efeemir103/DigitalDesignProject/README.md

# DigitalDesignProject
A simple design containing 16-bit custom CPU design, VGA Controller and IR Controller designs

Made by:

Efe Emir Pekmez

Alperen Yurdakul

Bahtiyar Annagurbanov
