efeemir103/DigitalDesignProject/Related/ALU.png

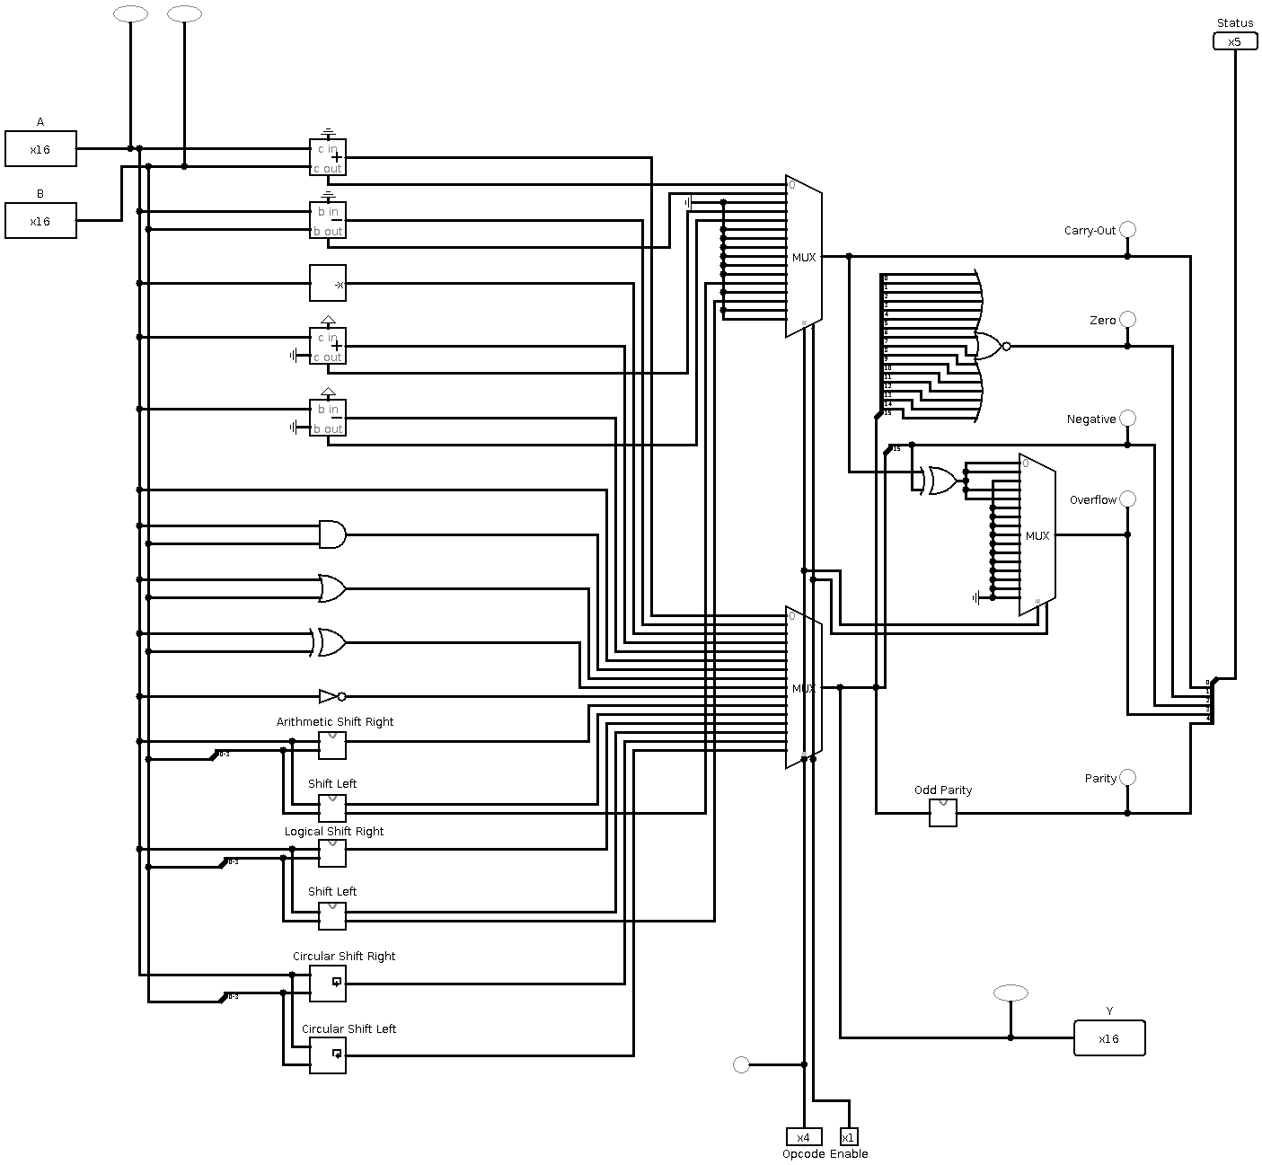
Related/ALU.png
