efeemir103/DigitalDesignProject/Related/Comparator2Bit.png

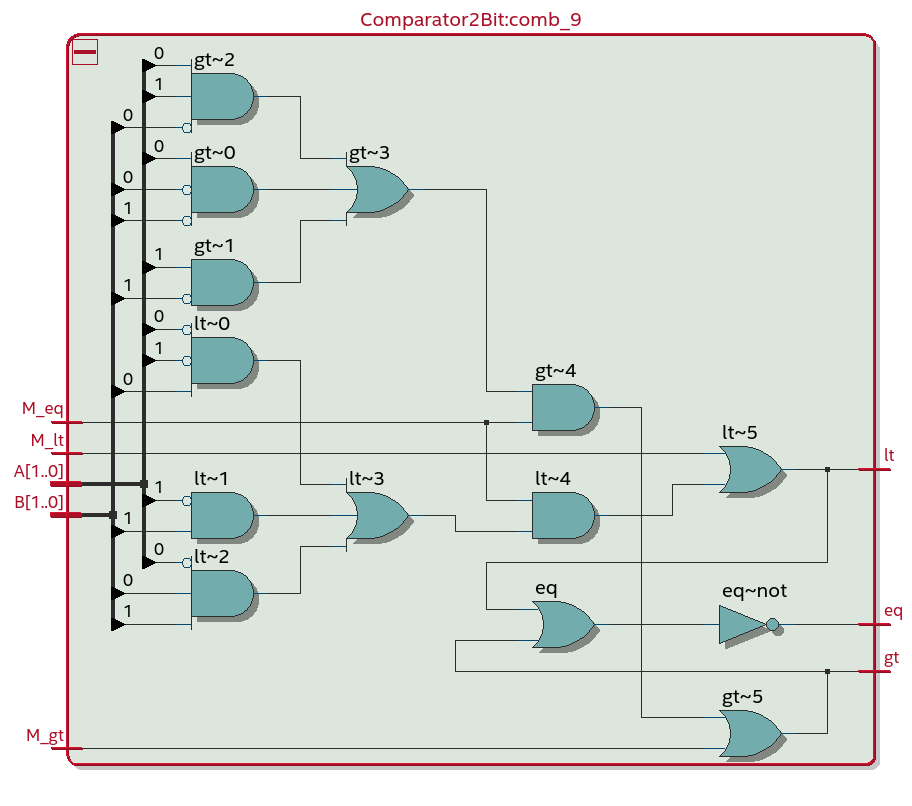
Related/Comparator2Bit.png
