efeemir103/DigitalDesignProject/Related/Comparator16Bit.png

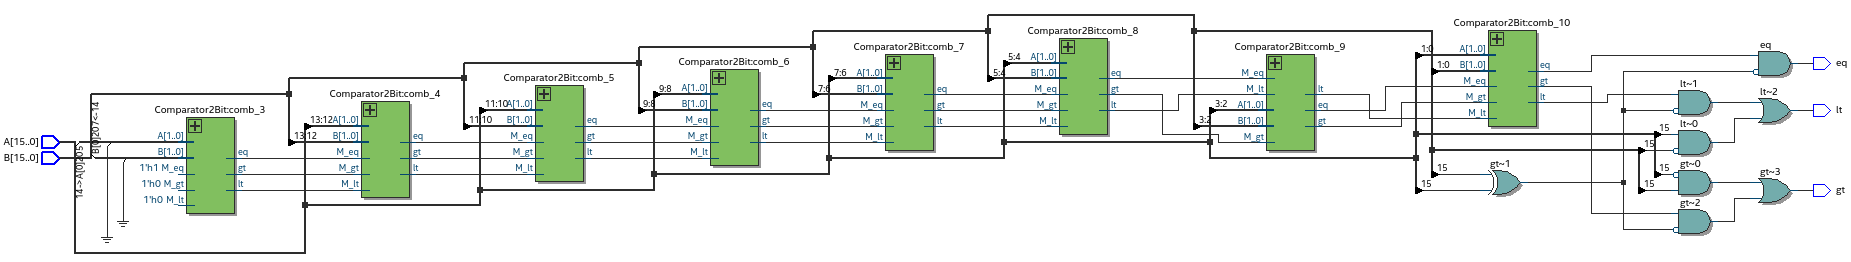
Related/Comparator16Bit.png
