efeemir103/DigitalDesignProject/Related/main.png

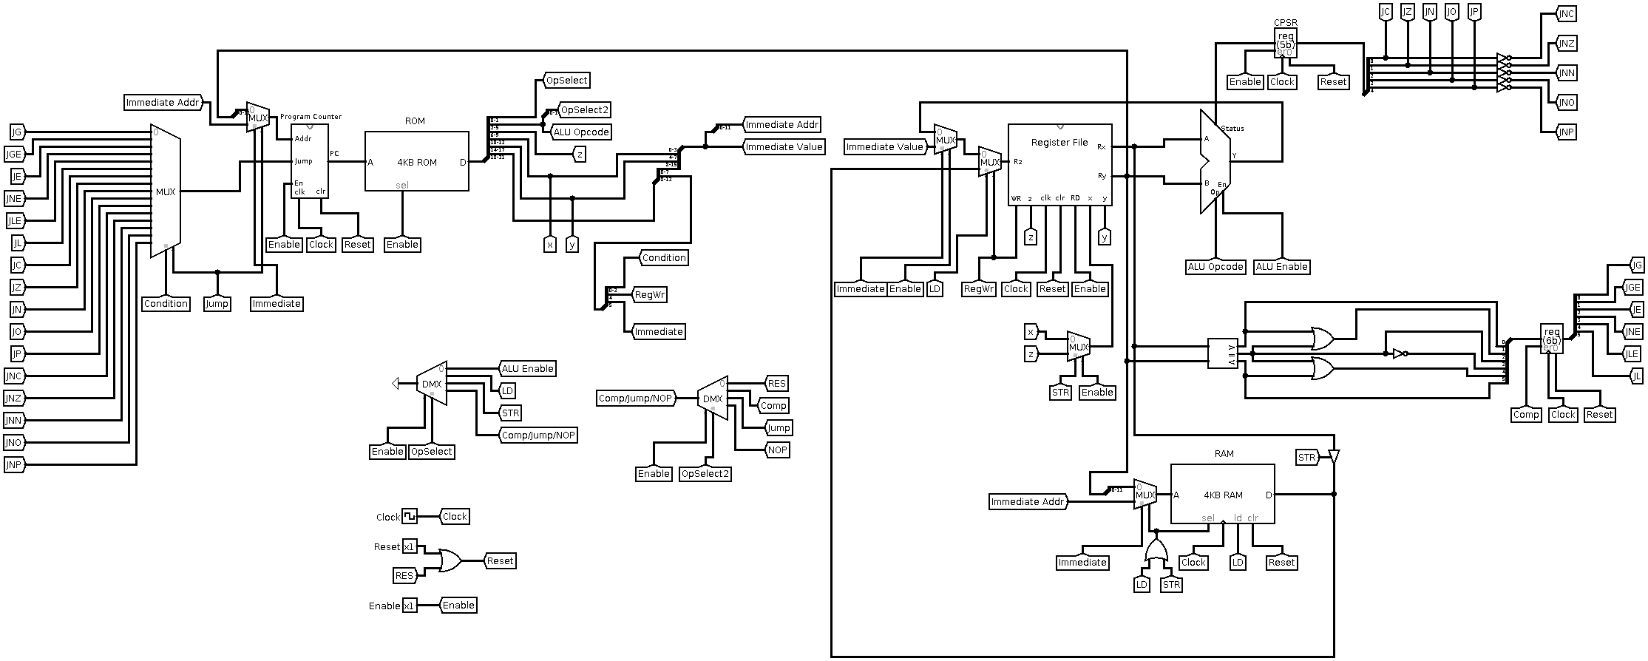
Related/main.png
