efeemir103/DigitalDesignProject/Related/Odd Parity.png

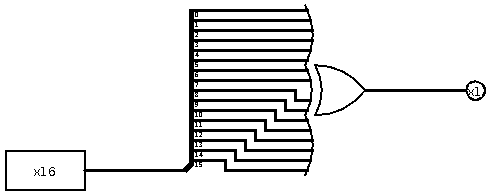
Related/Odd Parity.png
