efeemir103/DigitalDesignProject/Related/Program Counter.png

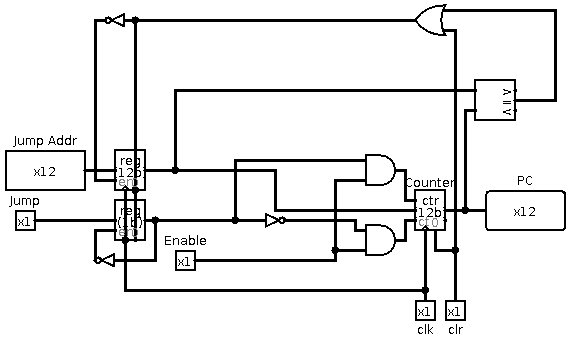
Related/Program Counter.png
