efeemir103/DigitalDesignProject/Related/Register File.png

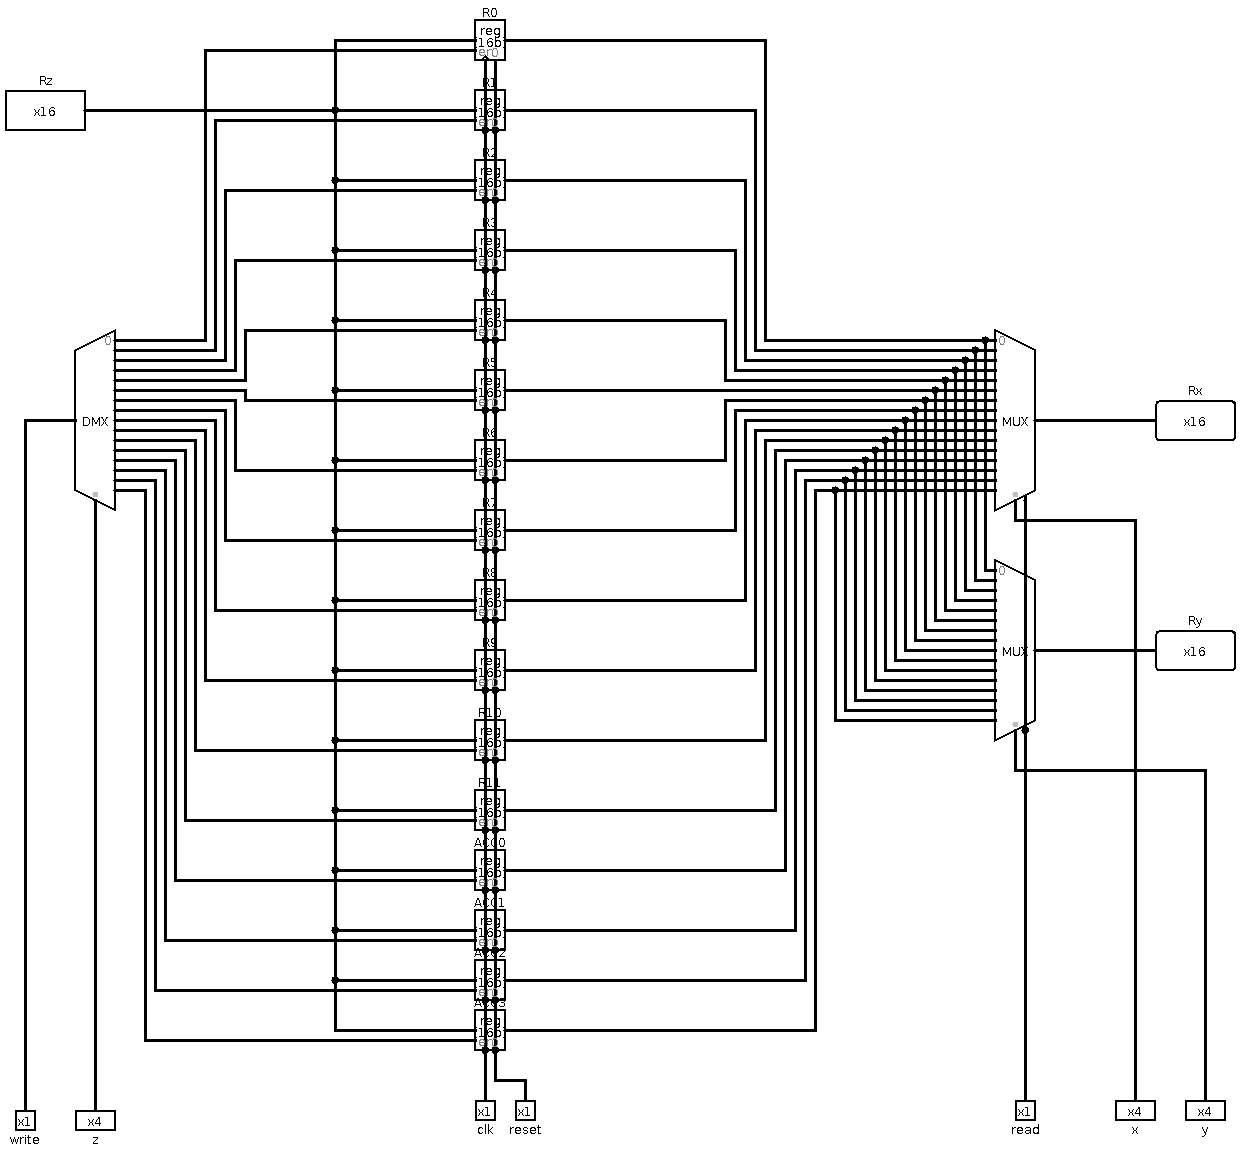
Related/Register File.png
