efeemir103/DigitalDesignProject/Related/Report/CPU/Adder16Bit.png

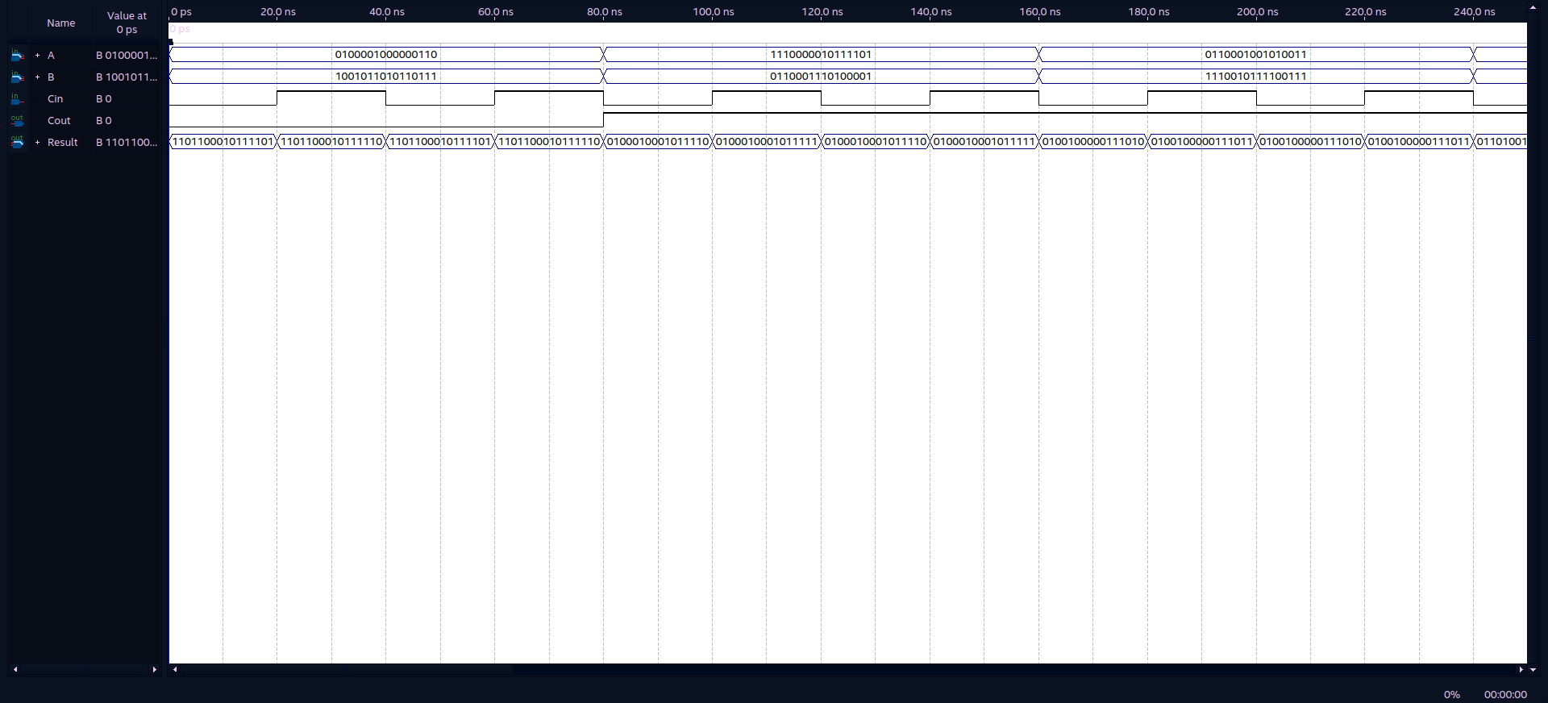
Related/Report/CPU/Adder16Bit.png
