efeemir103/DigitalDesignProject/Related/Report/CPU/ALU16Bit.png

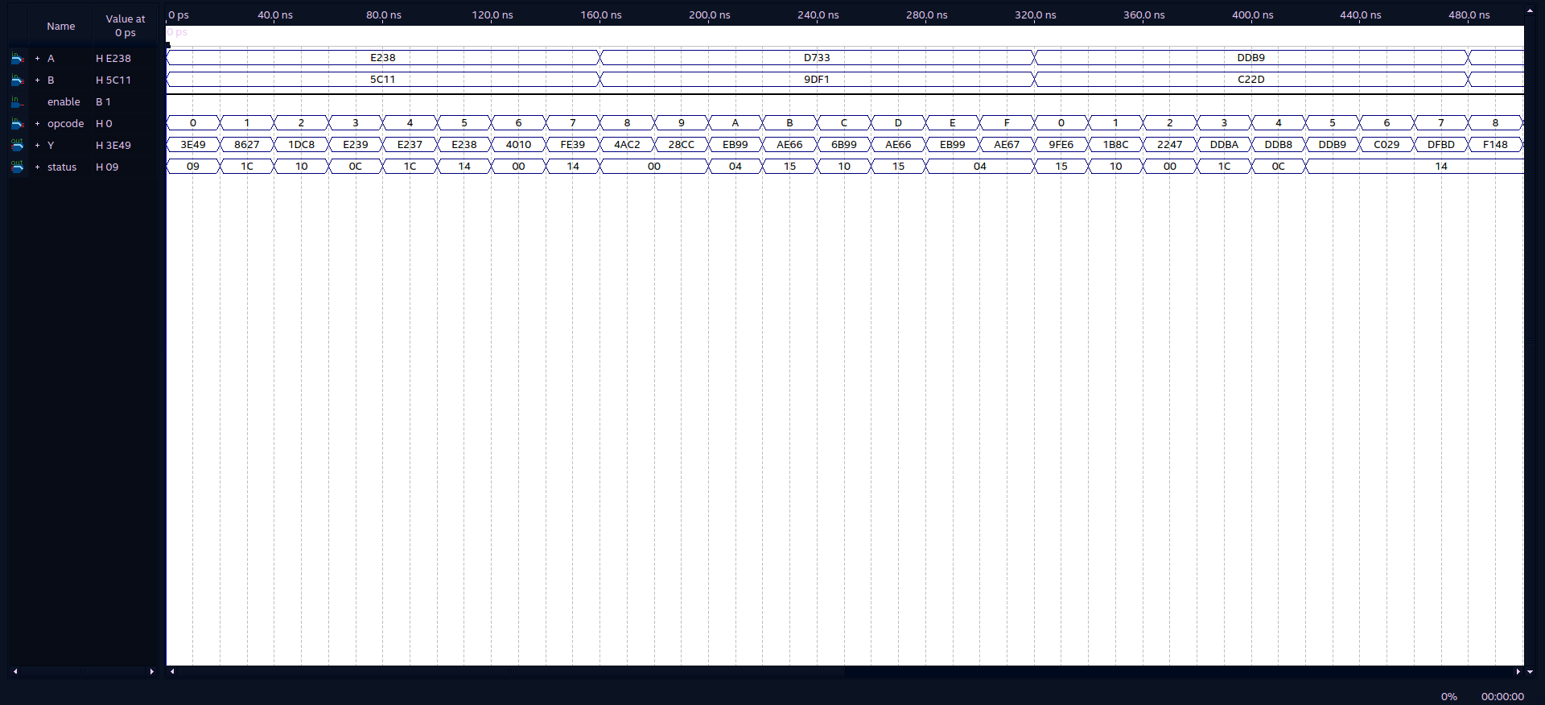
Related/Report/CPU/ALU16Bit.png
