efeemir103/DigitalDesignProject/Related/Report/CPU/ArithmeticShiftRight16Bit.png

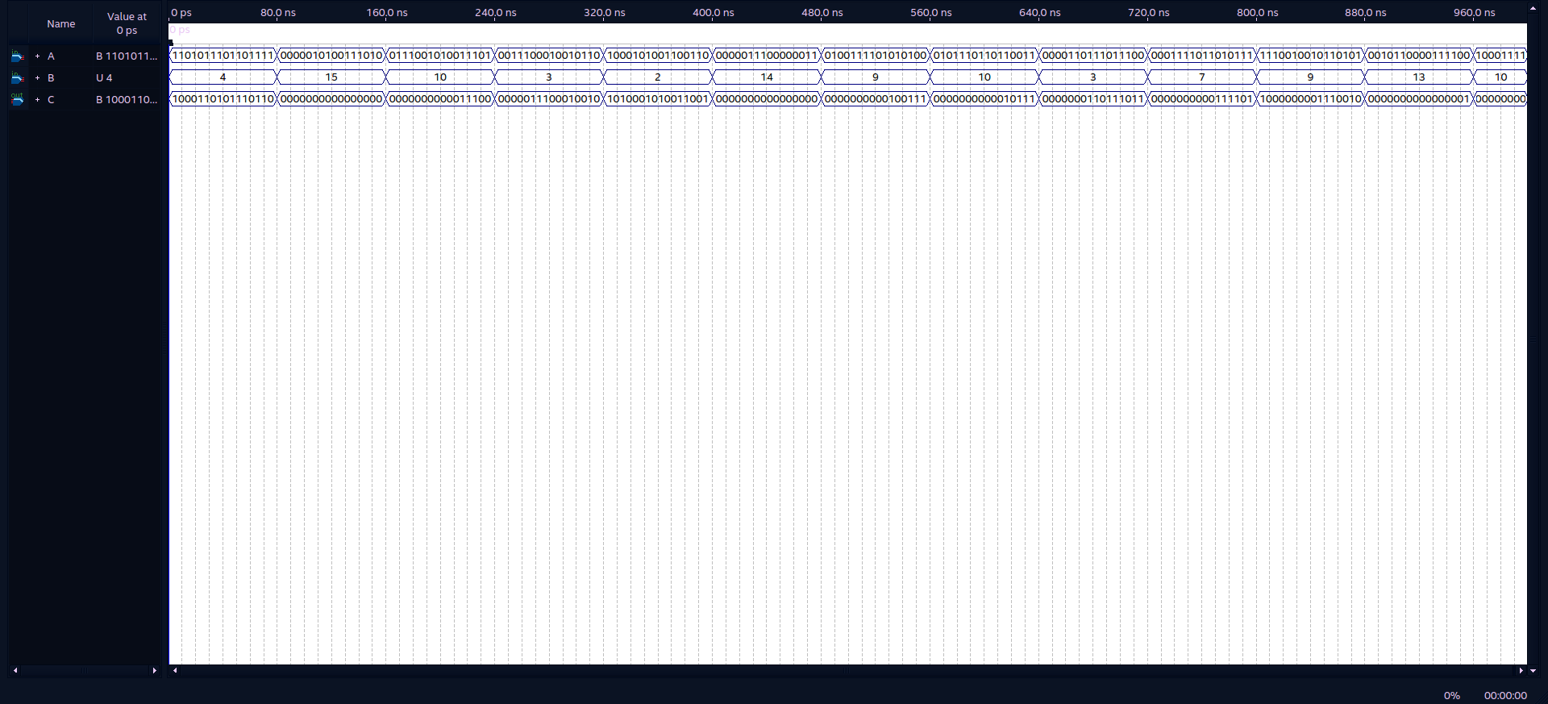
Related/Report/CPU/ArithmeticShiftRight16Bit.png
