efeemir103/DigitalDesignProject/Related/Report/CPU/CircularShiftRight16Bit.png

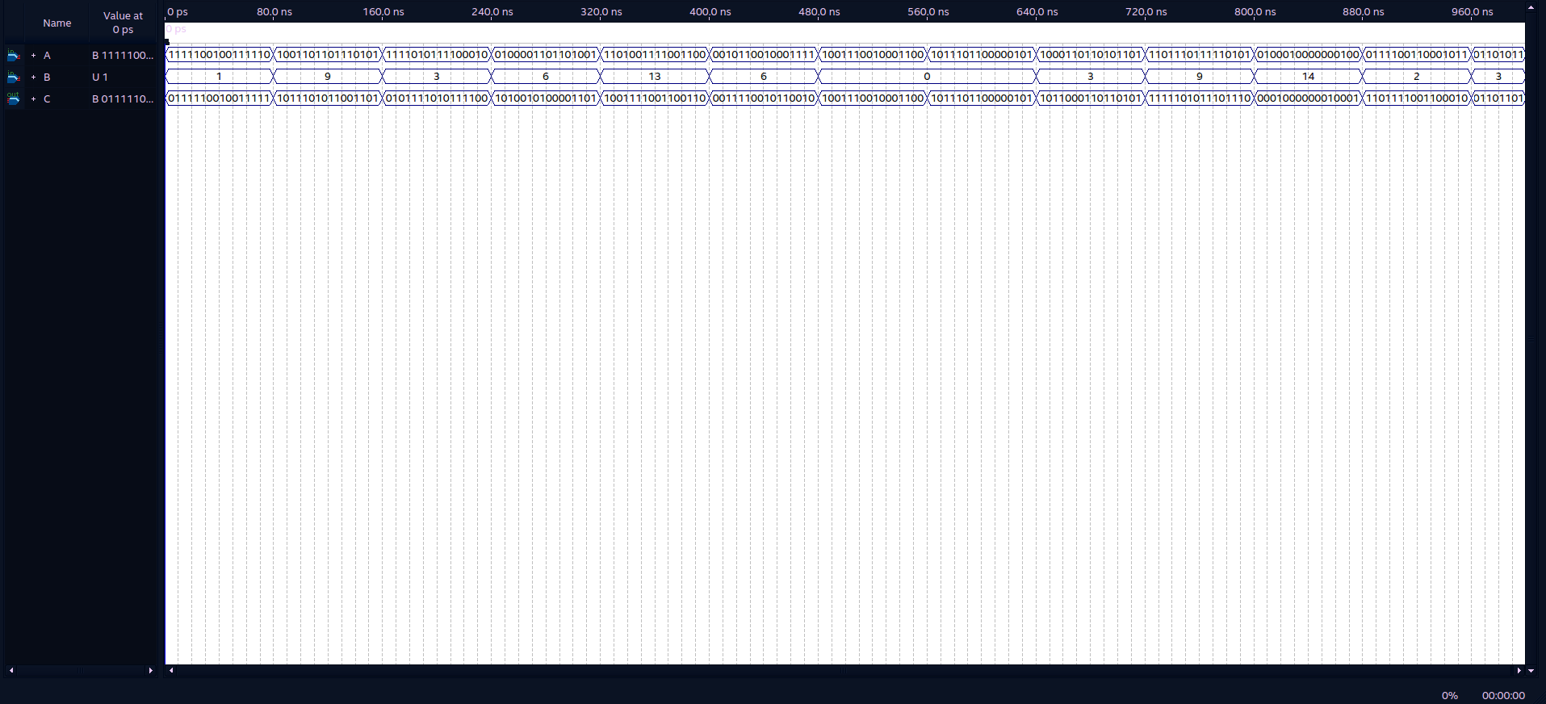
Related/Report/CPU/CircularShiftRight16Bit.png
