efeemir103/DigitalDesignProject/Related/Report/CPU/Comparator2Bit.png

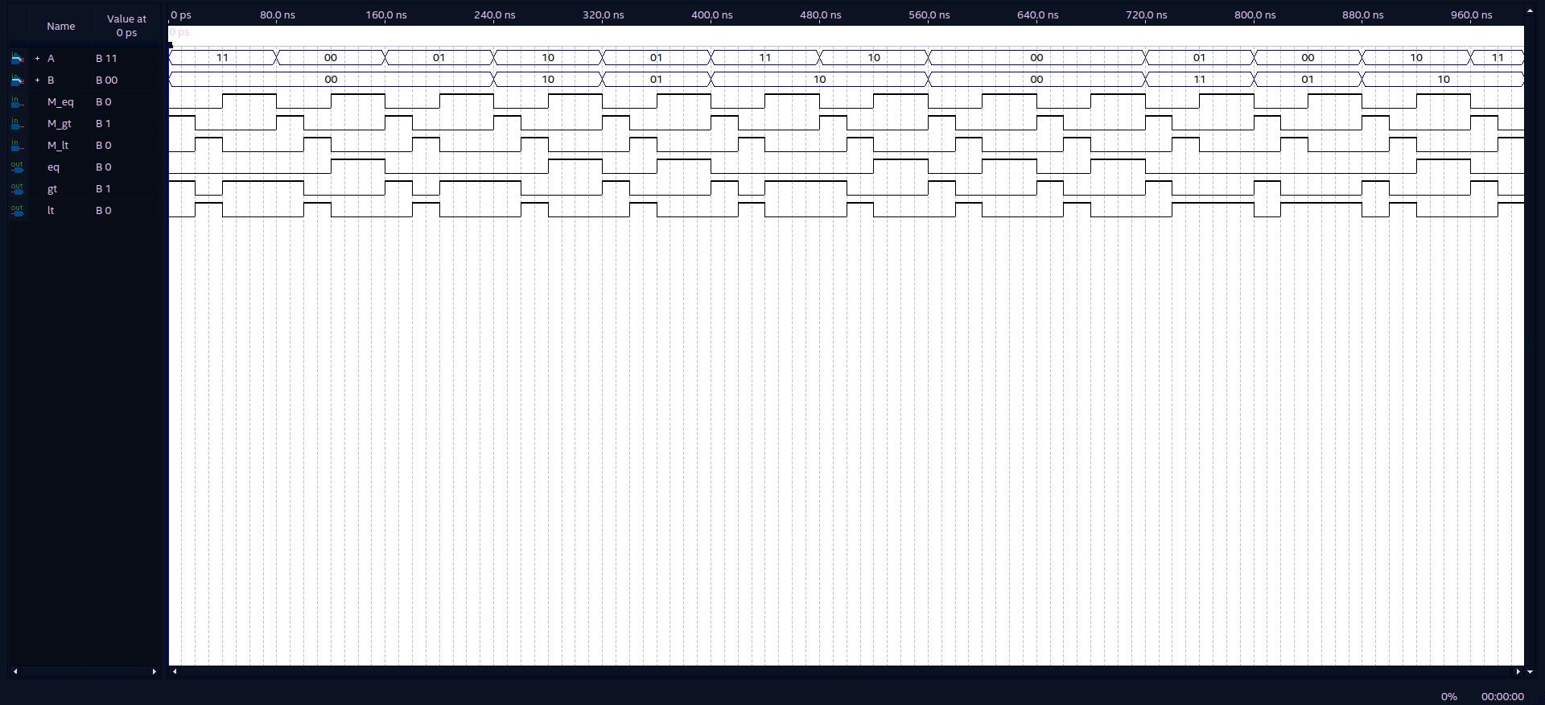
Related/Report/CPU/Comparator2Bit.png
