efeemir103/DigitalDesignProject/Related/Report/CPU/DEMUX1x2.png

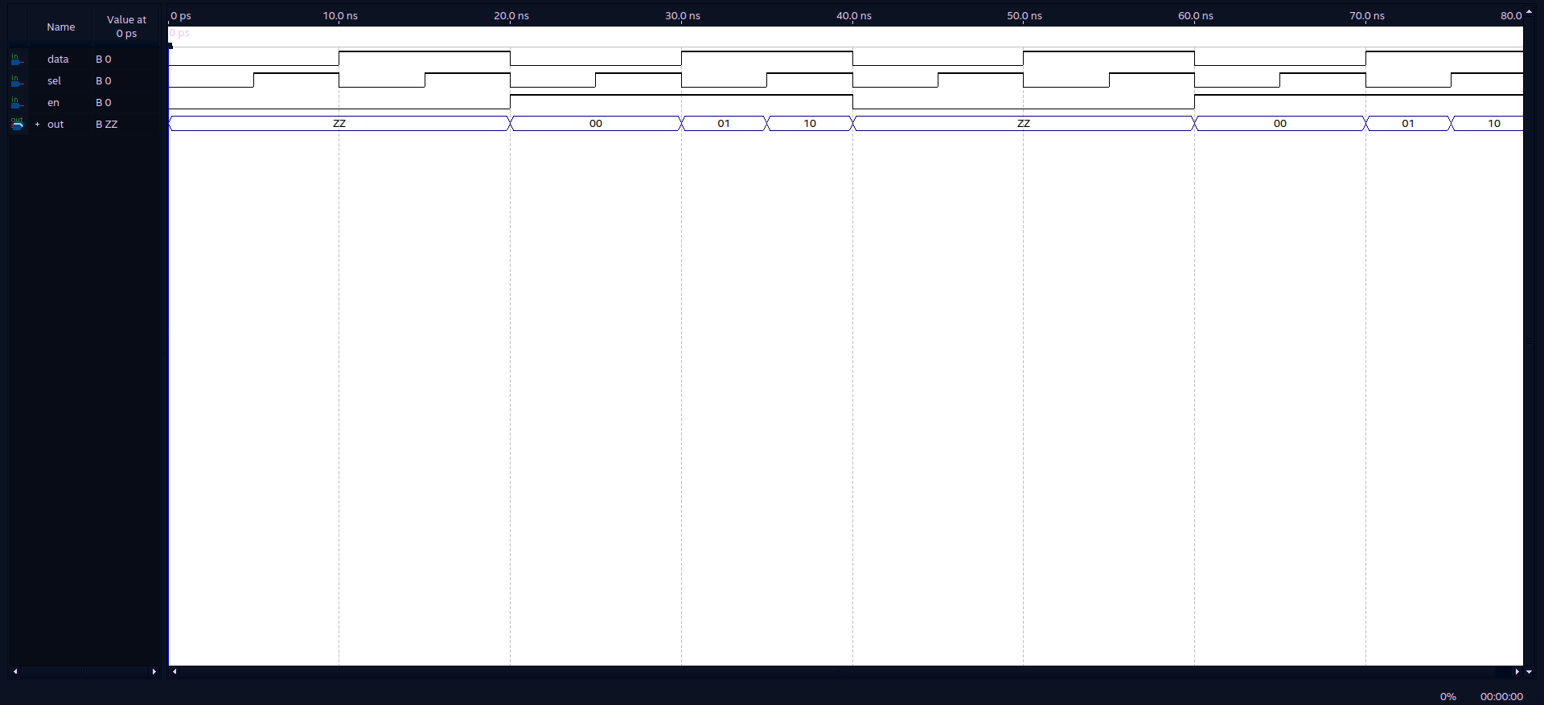
Related/Report/CPU/DEMUX1x2.png
