efeemir103/DigitalDesignProject/Related/Report/CPU/DEMUX1x4.png

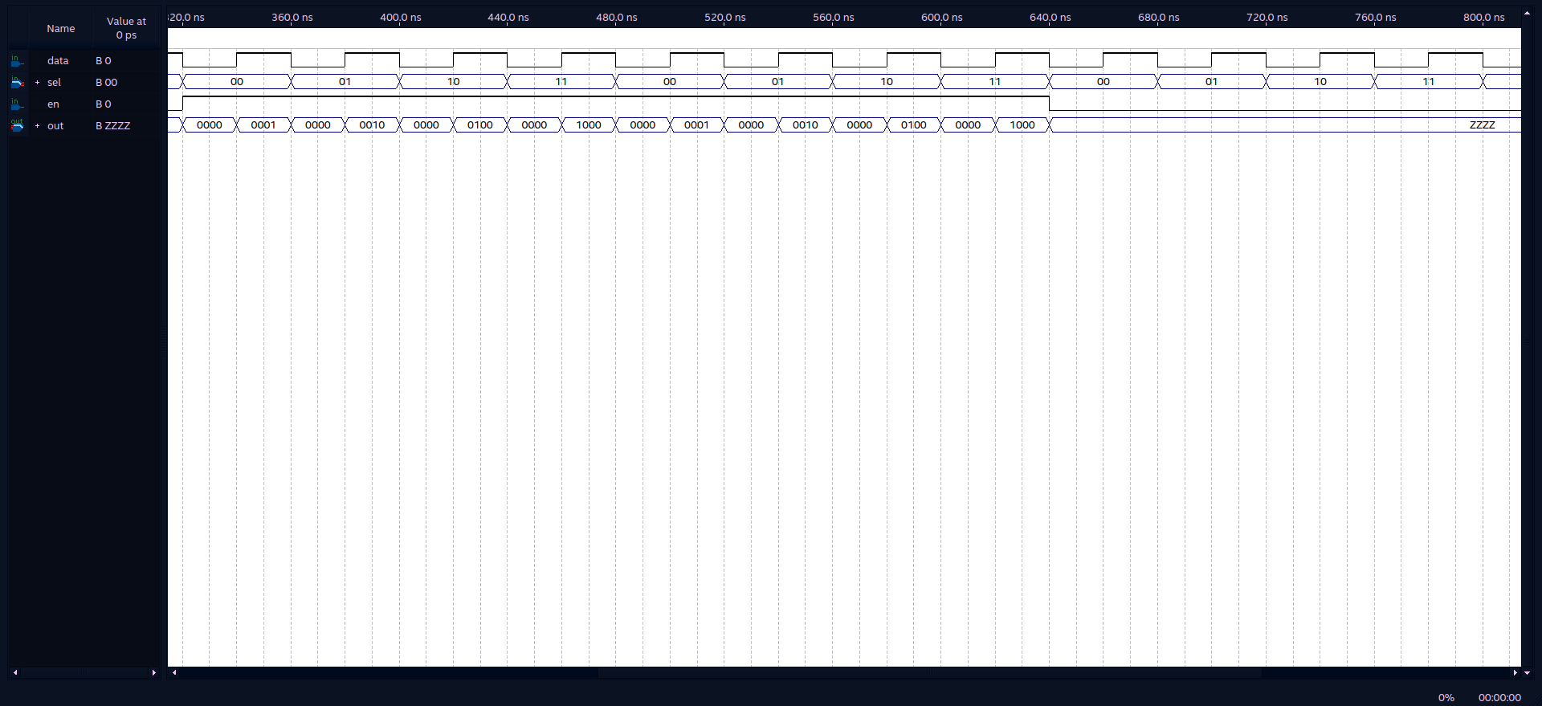
Related/Report/CPU/DEMUX1x4.png
