efeemir103/DigitalDesignProject/Related/Report/CPU/DEMUX1x8.png

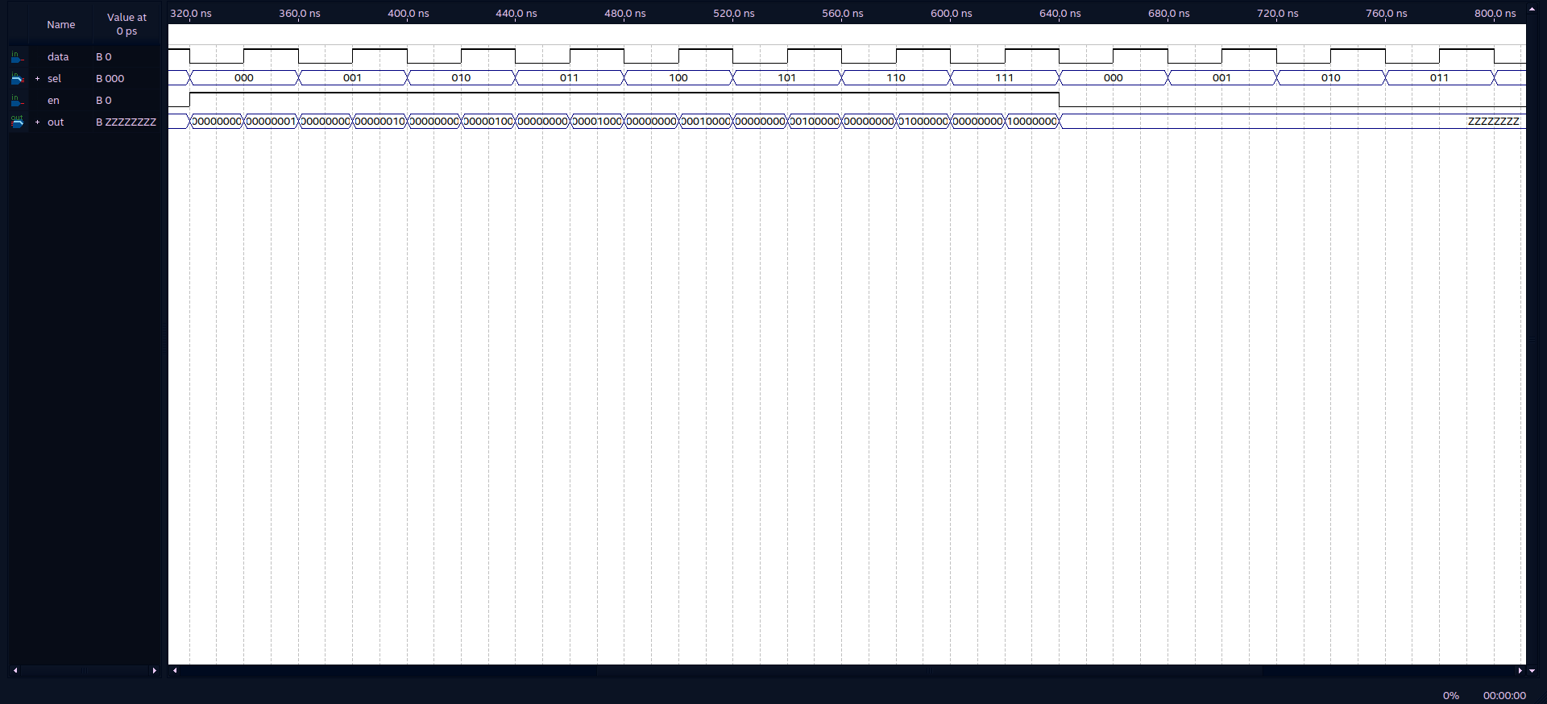
Related/Report/CPU/DEMUX1x8.png
