efeemir103/DigitalDesignProject/Related/Report/CPU/FullAdder.png

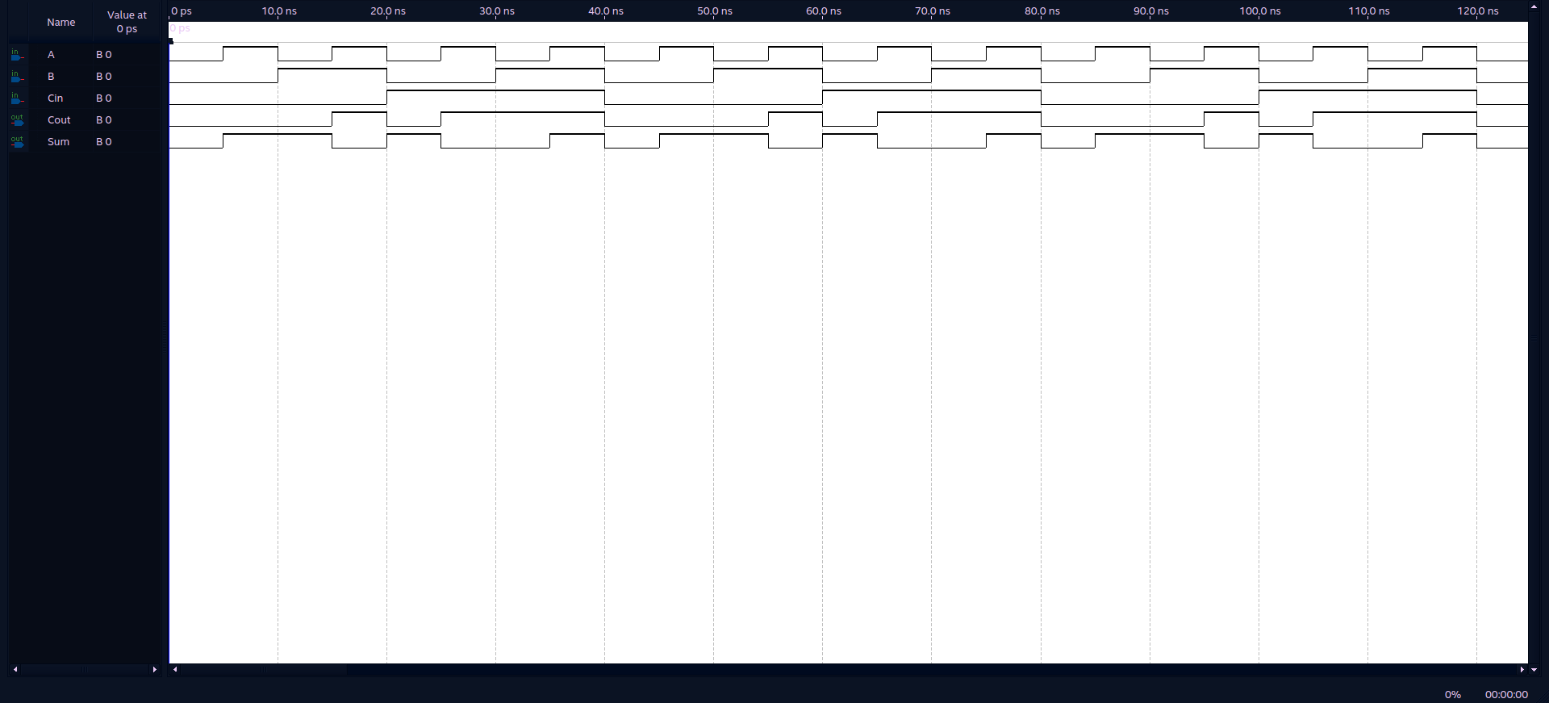
Related/Report/CPU/FullAdder.png
