efeemir103/DigitalDesignProject/Related/Report/CPU/MUX2x1.png

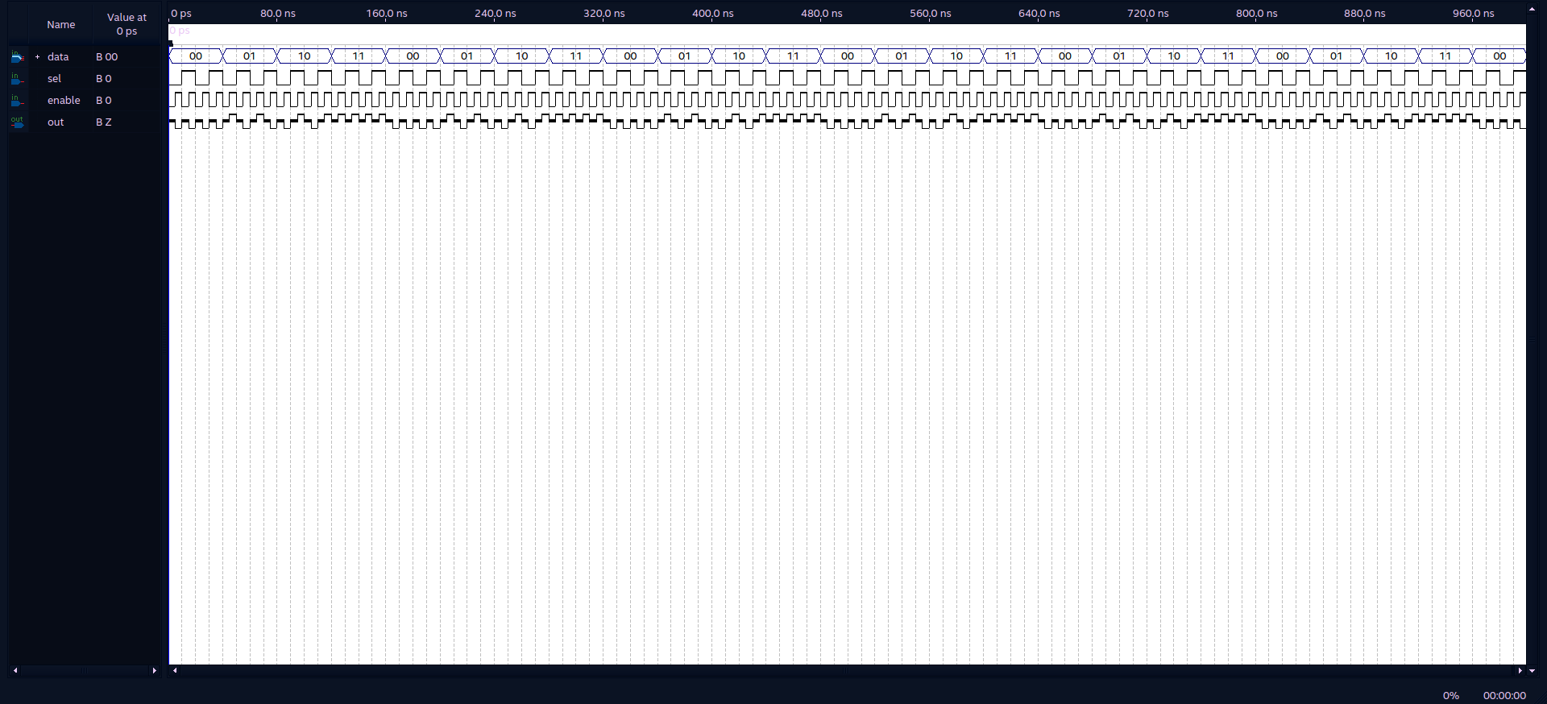
Related/Report/CPU/MUX2x1.png
