efeemir103/DigitalDesignProject/Related/Report/CPU/MUX2x4.png

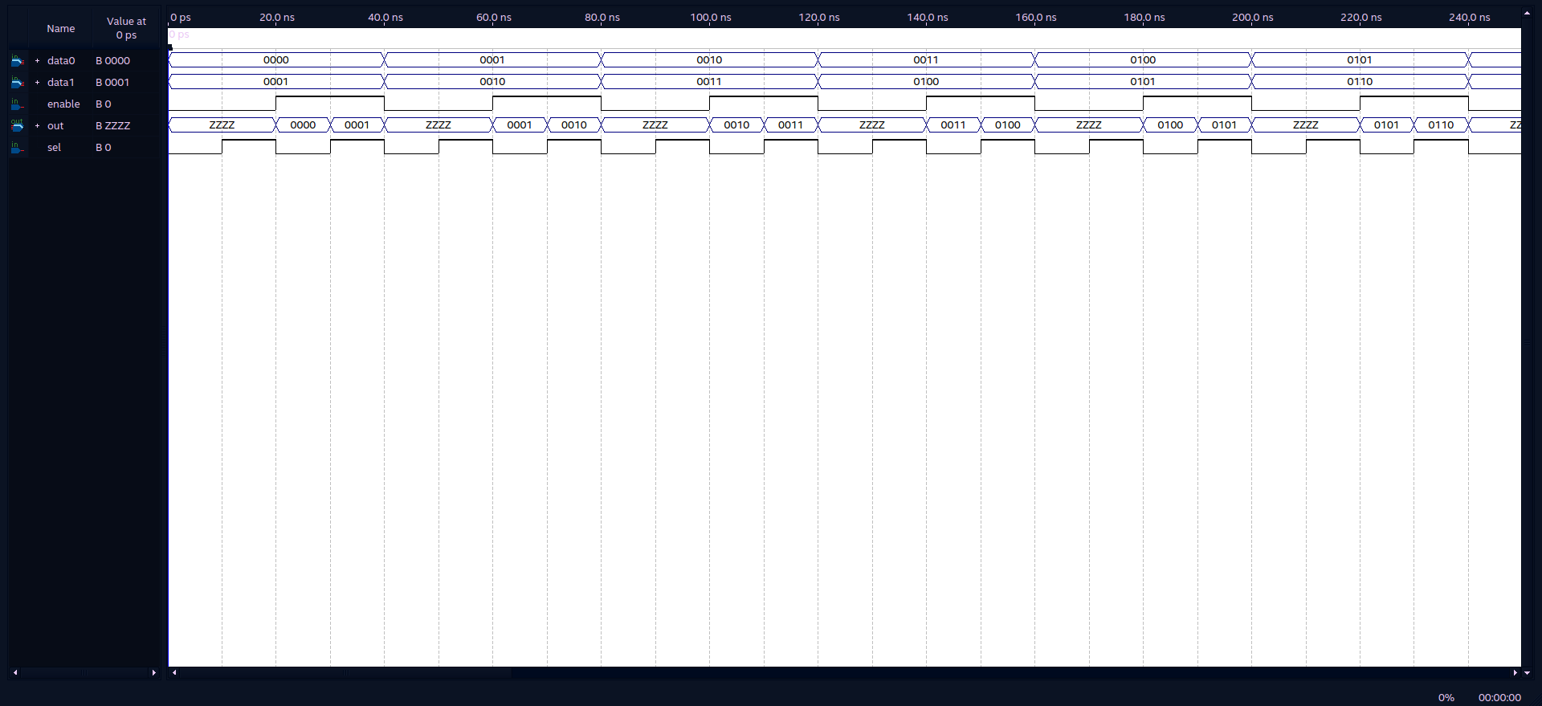
Related/Report/CPU/MUX2x4.png
