efeemir103/DigitalDesignProject/Related/Report/CPU/MUX2x12.png

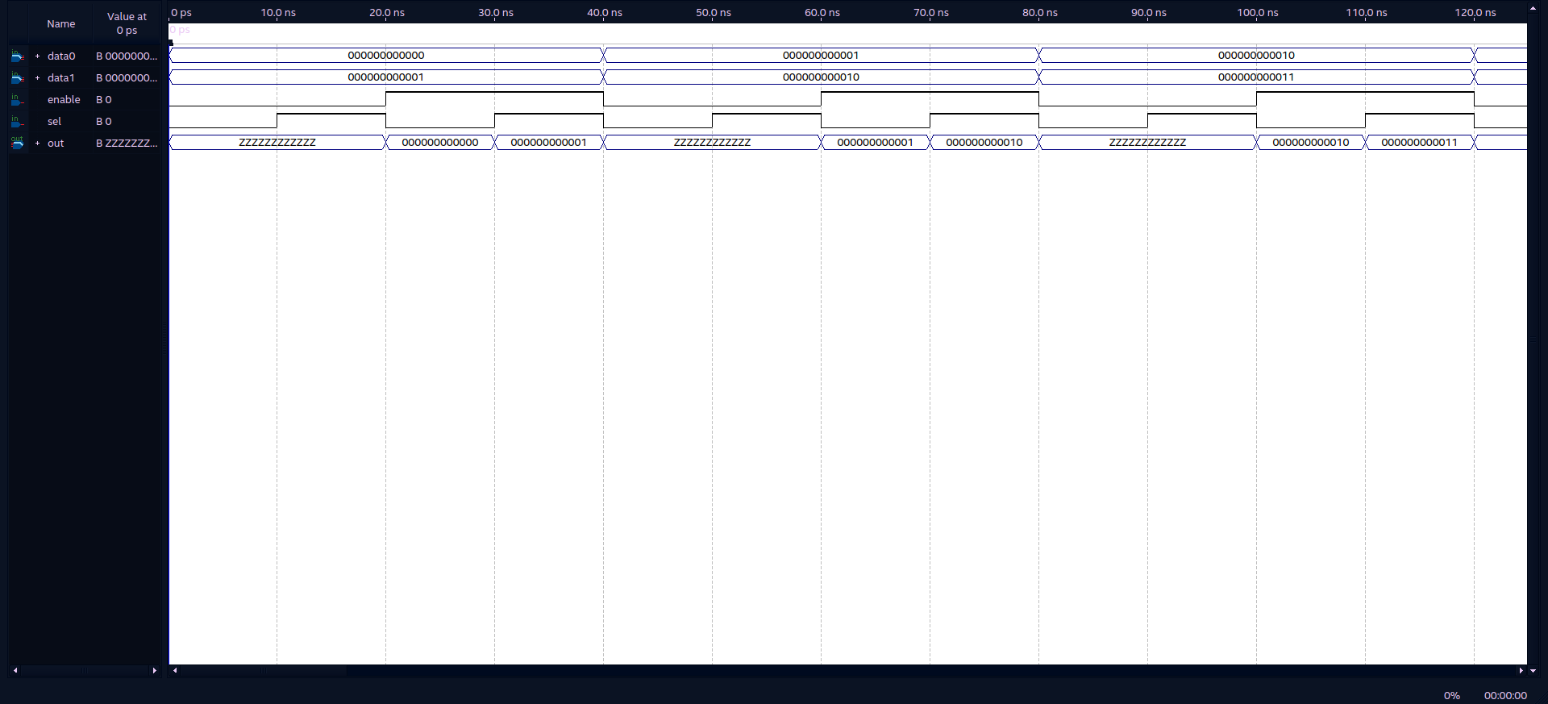
Related/Report/CPU/MUX2x12.png
