efeemir103/DigitalDesignProject/Related/Report/CPU/MUX4x1.png

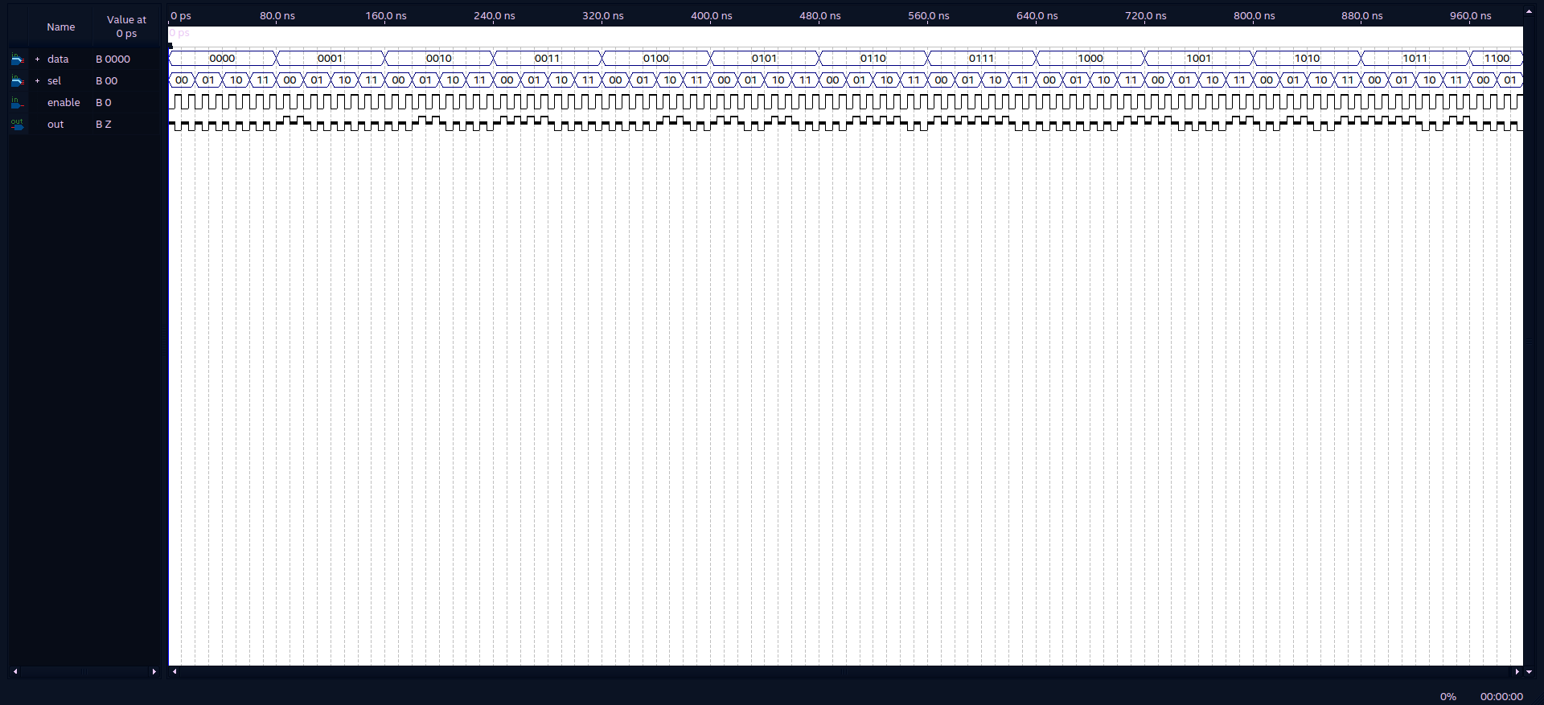
Related/Report/CPU/MUX4x1.png
