efeemir103/DigitalDesignProject/Related/Report/CPU/MUX16x16.png

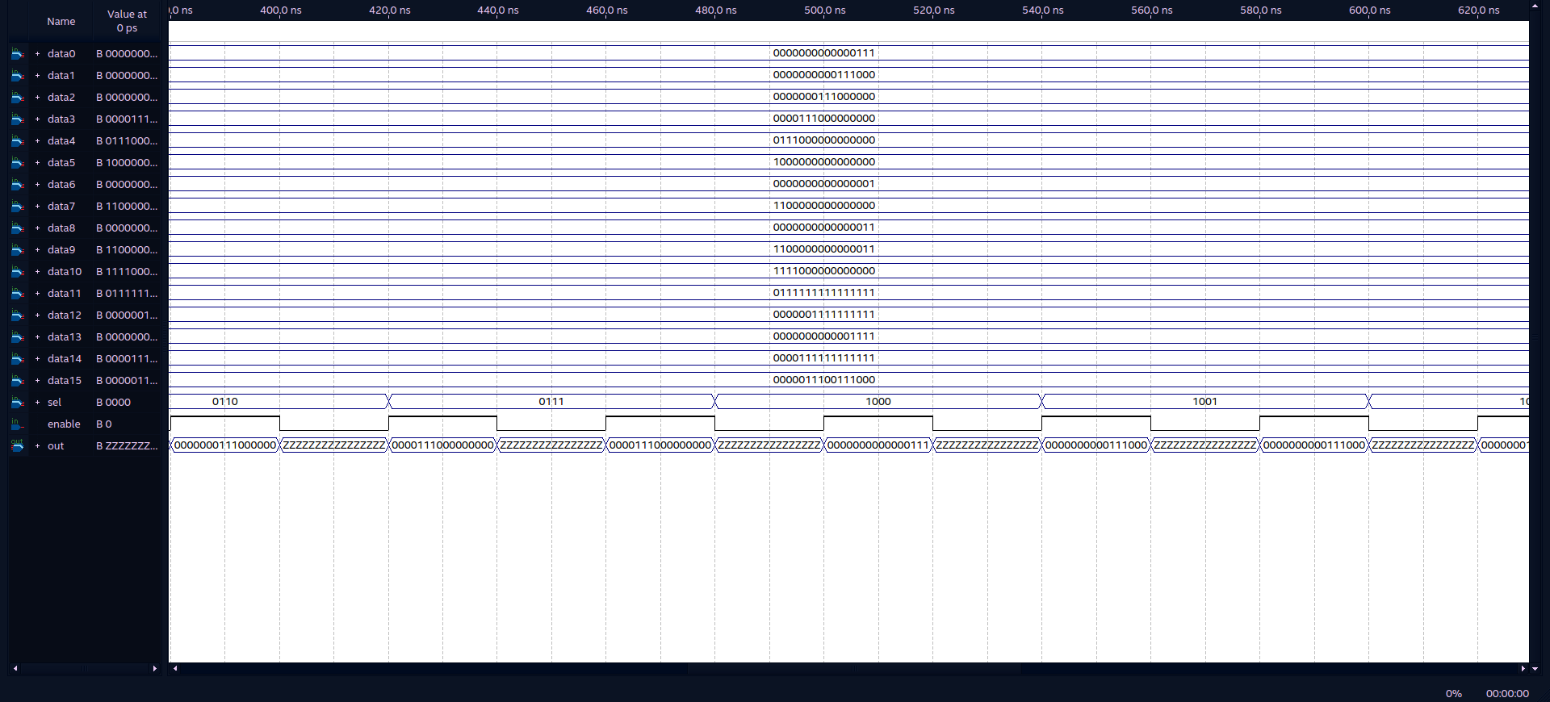
Related/Report/CPU/MUX16x16.png
