efeemir103/DigitalDesignProject/Related/Report/CPU/OddParity16Bit.png

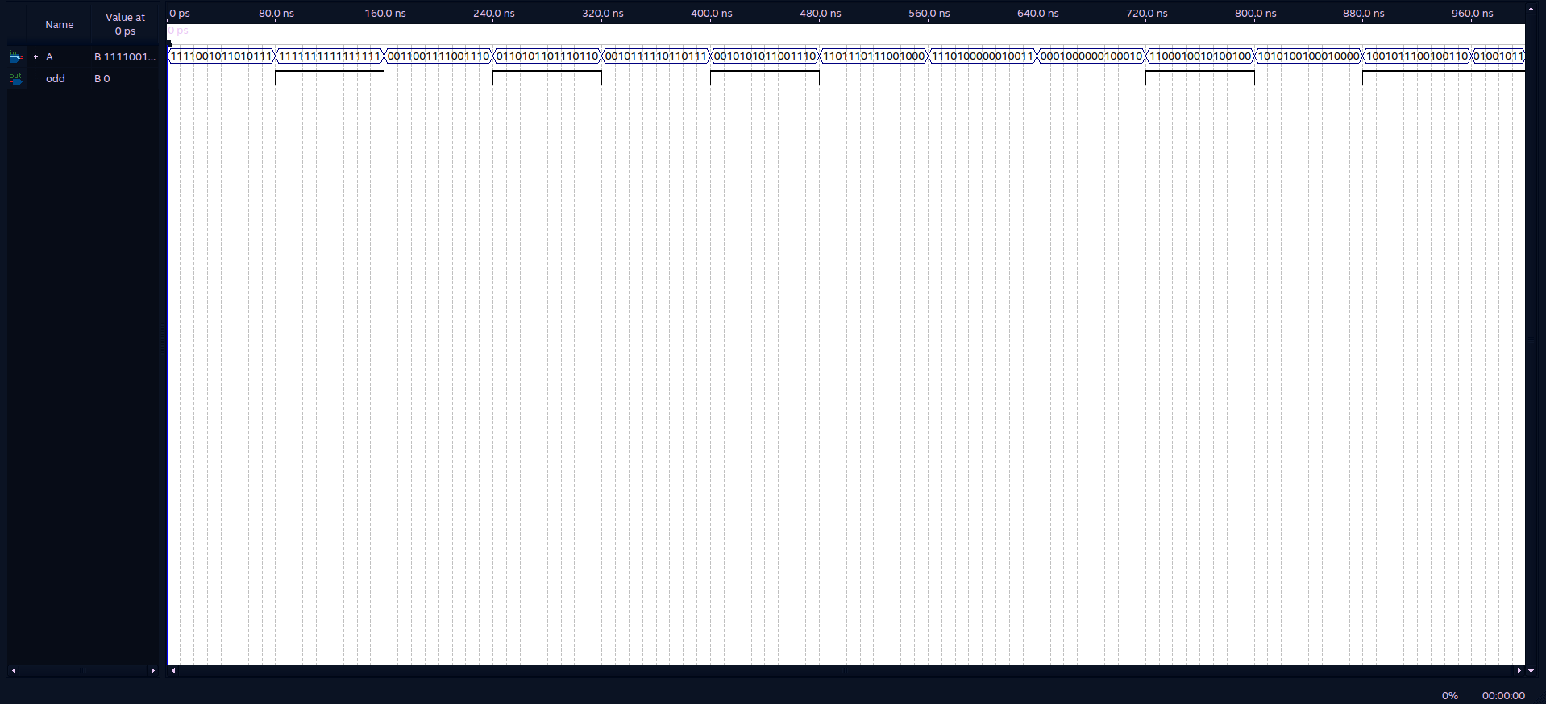
Related/Report/CPU/OddParity16Bit.png
