efeemir103/DigitalDesignProject/Related/Report/CPU/RegisterFile.png

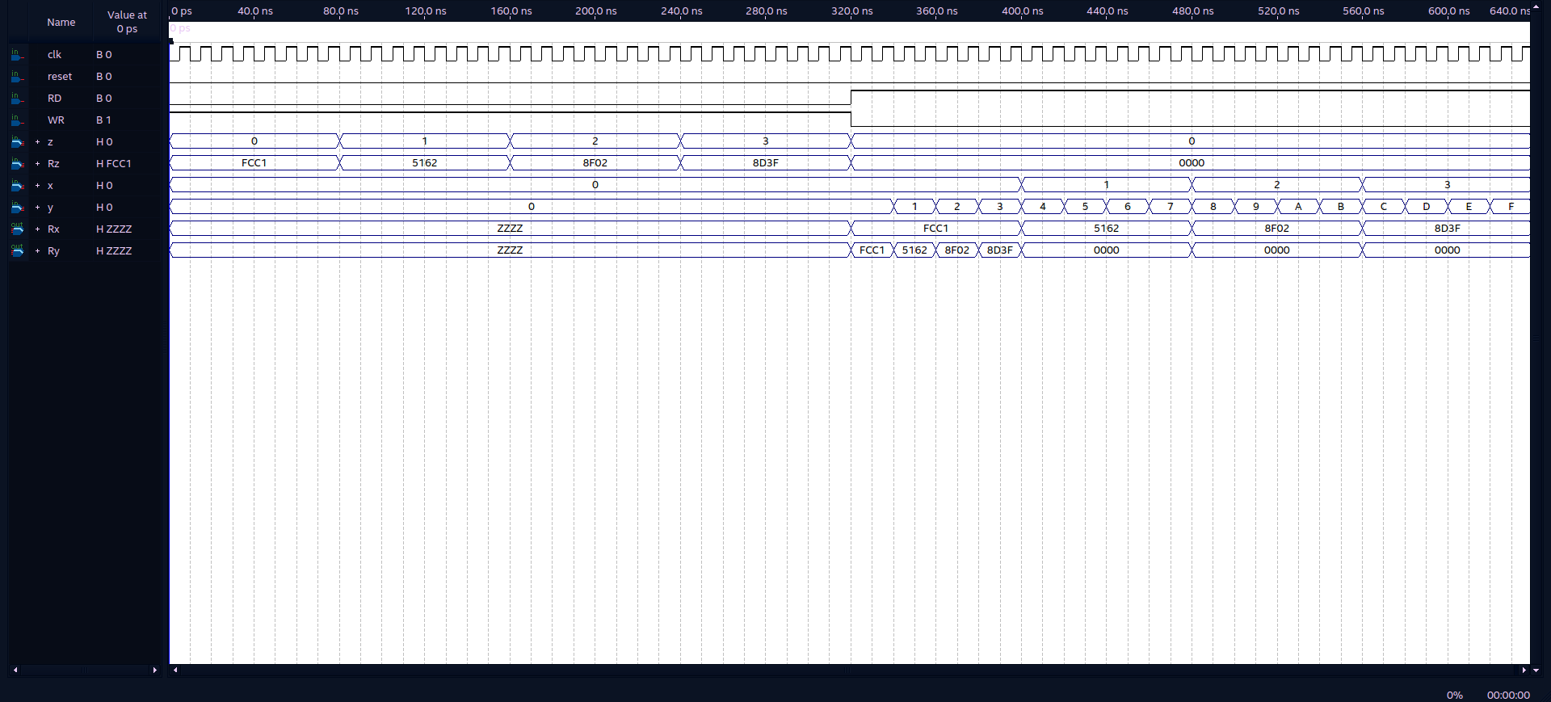
Related/Report/CPU/RegisterFile.png
