efeemir103/DigitalDesignProject/Related/Report/IR/IRControllerState.png

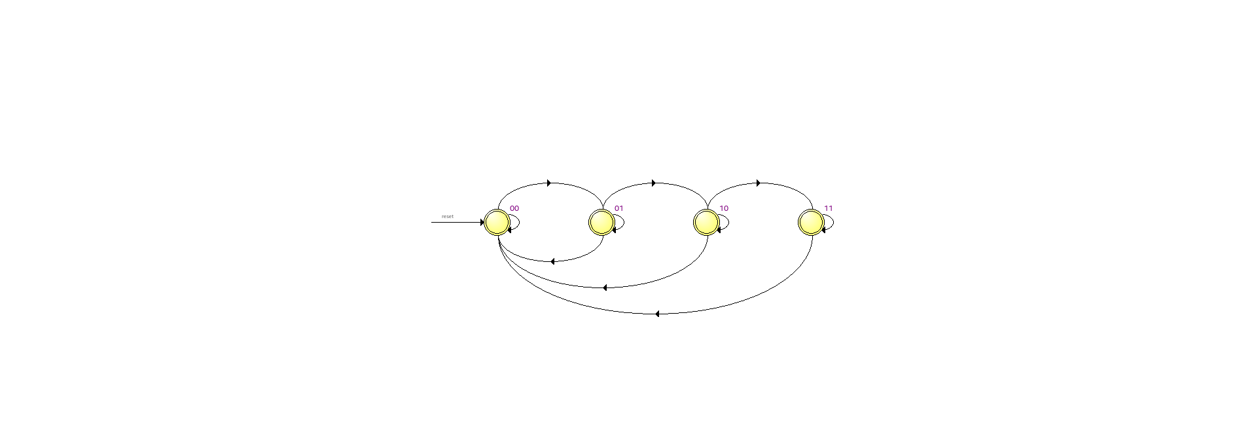
Related/Report/IR/IRControllerState.png
