efeemir103/DigitalDesignProject/Related/Report/VGA/netlist_HVSync.png

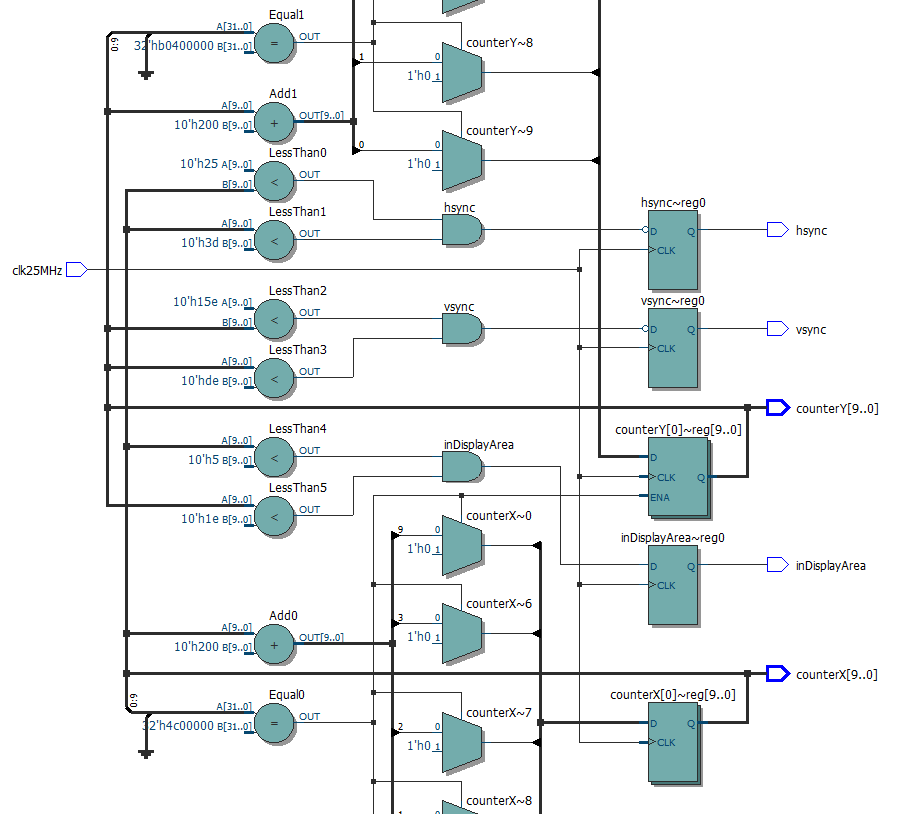
Related/Report/VGA/netlist_HVSync.png
