efeemir103/DigitalDesignProject/Related/Report/VGA/netlist_VGAController.png

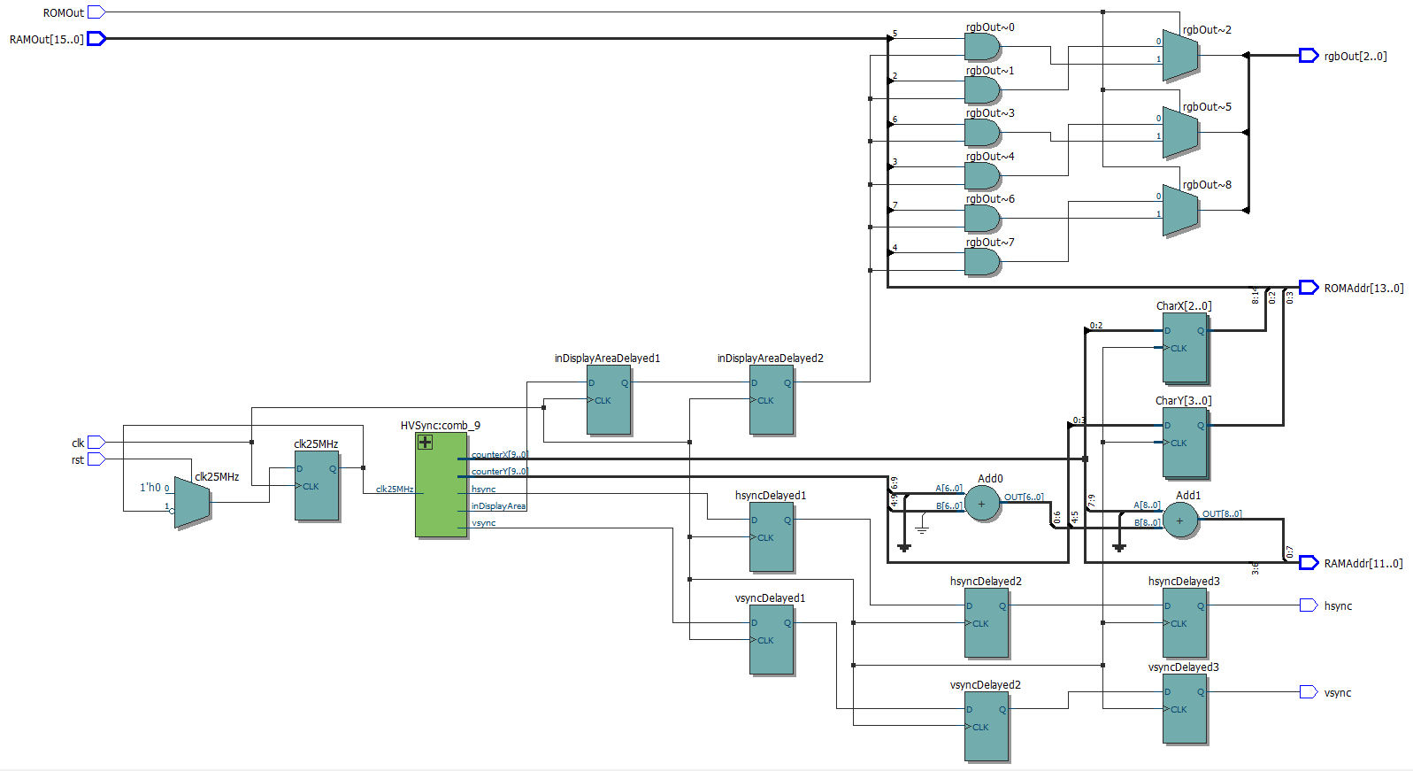
Related/Report/VGA/netlist_VGAController.png
