efeemir103/DigitalDesignProject/Related/Shift Left.png

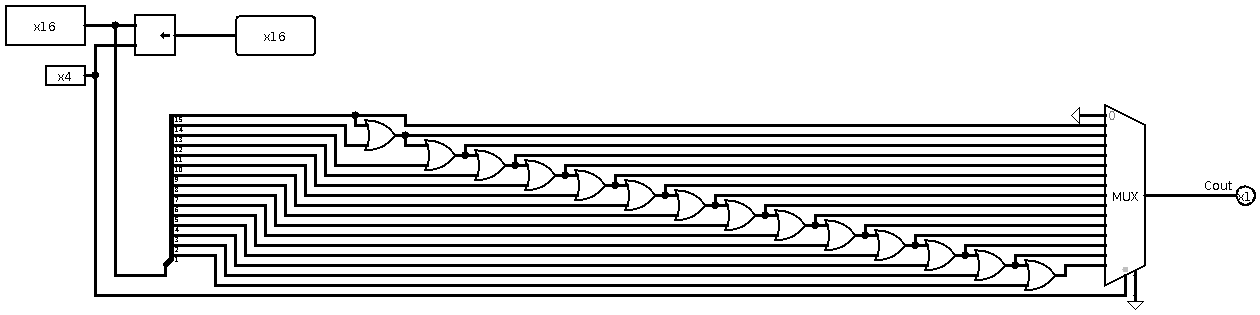
Related/Shift Left.png
