efeemir103/DigitalDesignProject/Related/assembler_table.ods

Command Table
ALU Instruction | B1, B0 | B3, B2 | B5, B4 | B9…B6 | B13...B10 | B17...B14 | B21...B18 | B25...B22 | B29…B26 | B30 | B31
ADD Rz, Rx, Ry | 00 | 00 | 00 | z | x | y | XXXX | XXXX | XXXX | 1 | 0
SUB Rz, Rx, Ry | 00 | 01 | 00 | z | x | y | XXXX | XXXX | XXXX | 1 | 0
NEG Rz, Rx | 00 | 10 | 00 | z | x | XXXX | XXXX | XXXX | XXXX | 1 | 0
INC Rz, Rx | 00 | 11 | 00 | z | x | XXXX | XXXX | XXXX | XXXX | 1 | 0
DEC Rz, Rx | 00 | 00 | 01 | z | x | XXXX | XXXX | XXXX | XXXX | 1 | 0
AND Rz, Rx, Ry | 00 | 10 | 01 | z | x | y | XXXX | XXXX | XXXX | 1 | 0
OR Rz, Rx, Ry | 00 | 11 | 01 | z | x | y | XXXX | XXXX | XXXX | 1 | 0
XOR Rz, Rx, Ry | 00 | 00 | 10 | z | x | y | XXXX | XXXX | XXXX | 1 | 0
NOT Rz, Rx | 00 | 01 | 10 | z | x | XXXX | XXXX | XXXX | XXXX | 1 | 0
ASR Rz, Rx, Ry | 00 | 10 | 10 | z | x | y | XXXX | XXXX | XXXX | 1 | 0
ASL Rz, Rx, Ry | 00 | 11 | 10 | z | x | y | XXXX | XXXX | XXXX | 1 | 0
LSR Rz, Rx, Ry | 00 | 00 | 11 | z | x | y | XXXX | XXXX | XXXX | 1 | 0
LSL Rz, Rx, Ry | 00 | 01 | 11 | z | x | y | XXXX | XXXX | XXXX | 1 | 0
CSR Rz, Rx, Ry | 00 | 10 | 11 | z | x | y | XXXX | XXXX | XXXX | 1 | 0
CSL Rz, Rx, Ry | 00 | 11 | 11 | z | x | y | XXXX | XXXX | XXXX | 1 | 0
MOV Instruction | B1, B0 | B3, B2 | B5, B4 | B9…B6 | B13...B10 | B17...B14 | B21...B18 | B25...B22 | B29…B26 | B30 | B31
MOV Rz, Rx | 00 | 01 | 01 | z | x | XXXX | XXXX | XXXX | XXXX | 1 | 0
MOV Rz, #Imm | 00 | 01 | 01 | z | 16-Bit Immediate Value |  |  |  | XXXX | 1 | 1
LD/STR Ins. | B1, B0 | B3, B2 | B5, B4 | B9…B6 | B13...B10 | B17...B14 | B21...B18 | B25...B22 | B29…B26 | B30 | B31
LD Rz, Ry | 01 | XX | XX | z | XXXX | y | XXXX | XXXX | XXXX | 1 | 1 | Register, Address
STR Rx, Ry | 10 | XX | XX | XXXX | x | y | XXXX | XXXX | XXXX | 0 | 1 | Value, Address
Immediates
LD/STR Ins. | B1, B0 | B3, B2 | B5, B4 | B9…B6 | B13...B10 | B17...B14 | B21...B18 | B25...B22 | B29…B26 | B30 | B31
LD Rz, #Imm | 01 | XX | XX | z | 12-Bit Address |  |  | XXXX | XXXX | 1 | 1 | Register, Address
STR Rx, #Imm | 10 | XX | XX | x | 12-Bit Address |  |  | XXXX | XXXX | 0 | 1 | Value, Address
Other Ins. | B1, B0 | B3, B2 | B5, B4 | B9…B6 | B13...B10 | B17...B14 | B21...B18 | B25...B22 | B29…B26 | B30 | B31
NOP | 11 | 11 | XX | XXXX | XXXX | XXXX | XXXX | XXXX | XXXX | 0 | X | No Operation
CMP Rx, Ry | 11 | 01 | XX | XXXX | x | y | XXXX | XXXX | XXXX | 0 | 0 | Compare / Test
RES | 11 | 00 | XX | XXXX | XXXX | XXXX | XXXX | XXXX | XXXX | 0 | X | Reset
JUMP Instruction | B1, B0 | B3, B2 | B5, B4 | B9…B6 | B13...B10 | B17...B14 | B21...B18 | B25...B22 | B29…B26 | B30 | B31
JG Ry | 11 | 10 | XX | XXXX | XXXX | y | XXXX | XXXX | 0000 | 0 | 0
JGE Ry | 11 | 10 | XX | XXXX | XXXX | y | XXXX | XXXX | 0001 | 0 | 0
JE Ry | 11 | 10 | XX | XXXX | XXXX | y | XXXX | XXXX | 0010 | 0 | 0
JNE Ry | 11 | 10 | XX | XXXX | XXXX | y | XXXX | XXXX | 0011 | 0 | 0
JLE Ry | 11 | 10 | XX | XXXX | XXXX | y | XXXX | XXXX | 0100 | 0 | 0
JL Ry | 11 | 10 | XX | XXXX | XXXX | y | XXXX | XXXX | 0101 | 0 | 0
JC Ry | 11 | 10 | XX | XXXX | XXXX | y | XXXX | XXXX | 0110 | 0 | 0
JZ Ry | 11 | 10 | XX | XXXX | XXXX | y | XXXX | XXXX | 0111 | 0 | 0
JN Ry | 11 | 10 | XX | XXXX | XXXX | y | XXXX | XXXX | 1000 | 0 | 0
JO Ry | 11 | 10 | XX | XXXX | XXXX | y | XXXX | XXXX | 1001 | 0 | 0
JP Ry | 11 | 10 | XX | XXXX | XXXX | y | XXXX | XXXX | 1010 | 0 | 0
JNC Ry | 11 | 10 | XX | XXXX | XXXX | y | XXXX | XXXX | 1011 | 0 | 0
JNZ Ry | 11 | 10 | XX | XXXX | XXXX | y | XXXX | XXXX | 1100 | 0 | 0
JNN Ry | 11 | 10 | XX | XXXX | XXXX | y | XXXX | XXXX | 1101 | 0 | 0
JNO Ry | 11 | 10 | XX | XXXX | XXXX | y | XXXX | XXXX | 1110 | 0 | 0
JNP Ry | 11 | 10 | XX | XXXX | XXXX | y | XXXX | XXXX | 1111 | 0 | 0
Immediates
JUMP Instruction | B1, B0 | B3, B2 | B5, B4 | B9…B6 | B13...B10 | B17...B14 | B21...B18 | B25...B22 | B29…B26 | B30 | B31
JG #Imm | 11 | 10 | XX | XXXX | 12-Bit Address |  |  | XXXX | 0000 | 0 | 1
JGE #Imm | 11 | 10 | XX | XXXX | 12-Bit Address |  |  | XXXX | 0001 | 0 | 1
JE #Imm | 11 | 10 | XX | XXXX | 12-Bit Address |  |  | XXXX | 0010 | 0 | 1
JNE #Imm | 11 | 10 | XX | XXXX | 12-Bit Address |  |  | XXXX | 0011 | 0 | 1
JLE #Imm | 11 | 10 | XX | XXXX | 12-Bit Address |  |  | XXXX | 0100 | 0 | 1
JL #Imm | 11 | 10 | XX | XXXX | 12-Bit Address |  |  | XXXX | 0101 | 0 | 1
JC #Imm | 11 | 10 | XX | XXXX | 12-Bit Address |  |  | XXXX | 0110 | 0 | 1
JZ #Imm | 11 | 10 | XX | XXXX | 12-Bit Address |  |  | XXXX | 0111 | 0 | 1
JN #Imm | 11 | 10 | XX | XXXX | 12-Bit Address |  |  | XXXX | 1000 | 0 | 1
JO #Imm | 11 | 10 | XX | XXXX | 12-Bit Address |  |  | XXXX | 1001 | 0 | 1
JP #Imm | 11 | 10 | XX | XXXX | 12-Bit Address |  |  | XXXX | 1010 | 0 | 1
JNC #Imm | 11 | 10 | XX | XXXX | 12-Bit Address |  |  | XXXX | 1011 | 0 | 1
JNZ #Imm | 11 | 10 | XX | XXXX | 12-Bit Address |  |  | XXXX | 1100 | 0 | 1
JNN #Imm | 11 | 10 | XX | XXXX | 12-Bit Address |  |  | XXXX | 1101 | 0 | 1
JNO #Imm | 11 | 10 | XX | XXXX | 12-Bit Address |  |  | XXXX | 1110 | 0 | 1
JNP #Imm | 11 | 10 | XX | XXXX | 12-Bit Address |  |  | XXXX | 1111 | 0 | 1
