efeemir103/DigitalDesignProject/Related/Report/IR/Netlist.pdf

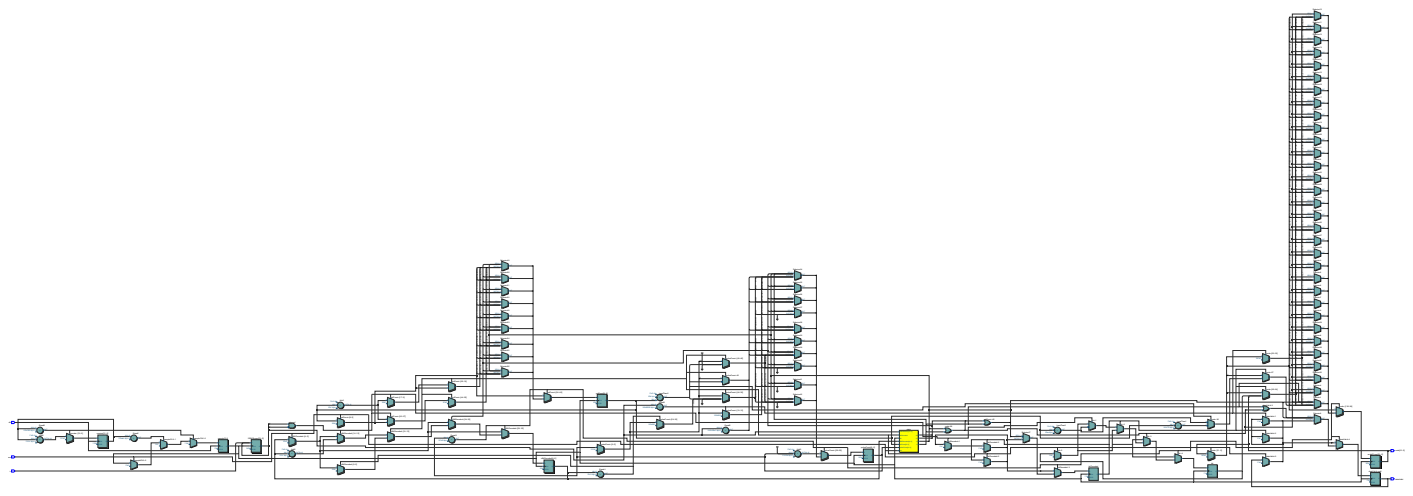
[picture p47: page 1]
Selector10; SEL[2..0] DATA[2..0]; OUT Selector11; OUT Selector12; OUT Selector13; OUT Selector14; OUT Selector15; OUT Selector16; OUT Selector17; OUT Selector18; OUT Selector19; OUT Selector20; OUT Selector21; OUT Selector2; OUT Selector22; OUT Selector23; OUT Selector24; OUT Selector25; OUT Selector26; OUT Selector27; OUT Selector28; OUT Selector3; OUT Selector5; OUT; Selector49; Selector6; Selector50; Selector7; Selector51; Selector9; Selector52; Selector29; Selector48; OUT Selector53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

state
IRBitStream[23..0] nBitDecoded[4..0] pdCount[8..0] pulseCount[9..0]
bitDecoded
clk

code~98 | pdCount~45 | 1'h0 CIN LessThan2
