efeemir103/DigitalDesignProject/(list of files, drawings)

Other design files:
Related/16BitCPU.circ
