efeemir103/DigitalDesignProject/Project/Register5Bit.v

module Register5Bit(
	input [4:0] D,
	input clk,
	input en,
	input clr,
	output reg [4:0] Q
);
	
	initial begin
		Q <= 5'h000;
	end
	
	always @(posedge clk or posedge clr)
	begin
		if(clr) begin
			Q <= 5'h000;
		end
		else begin
			Q <= en ? D: Q;
		end
	end

endmodule
