efeemir103/DigitalDesignProject/(commit log)

2021-02-08 CPUTester: Still not working
    [16BitCPU.circ, assembler_table.xlsx]
2021-02-08 At least now it compiles
    [16BitCPU.circ]
2021-02-09 Ok at least buttons are working fine.
    [16BitCPU.circ]
2021-02-09 Changed all tri-state to floating to zero
    [16BitCPU.circ]
2021-02-09 Finally looks like it is working.
    [16BitCPU.circ]
2021-02-09 Fixed a bug in assembler
    [assembler_table.ods, assembler_table.xlsx]
2021-02-09 Trying a different approach
    [16BitCPU.circ]
2021-02-09 DEAD LOOP
    [16BitCPU.circ]
2021-02-10 Still not...
    [16BitCPU.circ]
2021-02-15 ALU bug fixed
    [assembler_table.ods, assembler_table.xlsx]
