efeemir103/DigitalDesignProject/Related/Report/IR/IMG_20210210_235432.jpg

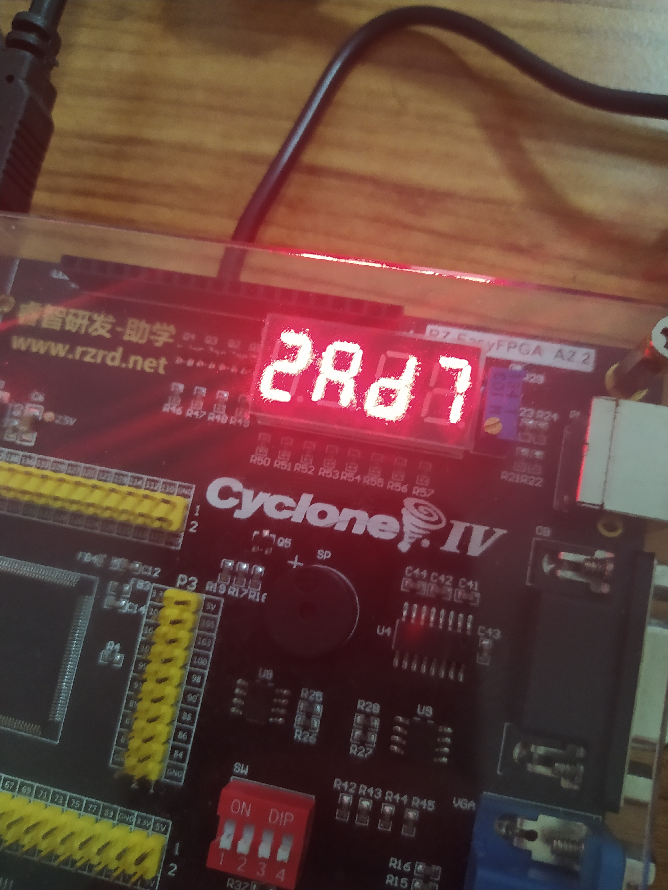
Related/Report/IR/IMG_20210210_235432.jpg
